Jaime-y-Yev/TFM/Presentación TFM - Jaime Salazar Lahera.pptx

## Intro

- Revolución Industrial (s. XVIII) → Automatización del campo (s. XXI)
- Agricultura de precisión
- Beneficios
  - Económicos: ↓ tiempo, trabajadores
  - Ecológicos: ↓ nutrientes, pesticidas, agua

Contexto

## Intro

- Vinbot → tamaño, visión
- Farmbot → sondeo, interfaz/control
- Nasa → pequeñas paladas
- Accesorios de tractores/camiones → dimensiones reales
- Bases para aficionados → Agent390 de Actobotics
  - Peso
  - Precio
  - Flexibildad

Inspiración

## Intro

- Base
  - Agujero central
  - Contorno de sonar
  - Oruga
- Delante
  - Batería de moto 12V 12Ah
  - Pared
  - ArduinoB y relé: batería secundaria 5V → convertidor boost → 12Vç
- Detrás
  - ArduinoA
  - Controlador de motores
  - Motores 12V c.c. con cepillo + codificadores

Anatomía

interruptor 3 posiciones → Motores, actuador lineal, servos

## Intro

- Centro
  - 2 RPi
    - PiA: navegación (GPS + motores)
    - PiB: sondeo, seguridad
  - Jaula sobre raíles
  - Servomotor + biela-manivela
  - Actuador lineal + sonda
  - Webcam
  - Baterías secundarias
  - Controlador de carga solar
  - Paneles solares, magnetómetro, antena GPS

Anatomía

## Intro

Parte A
- Infraestructura digital
  - Interfaz gráfica (webapp)
  - Base de datos SQL
  - Comunicación MQTT servidor-robot
- Navegación
  - Motores: dimensionado, control
  - Nav manual: MQTT a la cámara y los motores
  - Nav autónoma: comunicación serie PiA-ArduinoA
- Sondeo: almacenar y visualizar datos
- Visión: tomar fotos y analizar RGB
- Seguridad:
  - Batería principal: ↑ temp, humedad
  - Batería secundaria: ↓ tensión
- Dr. Alberto Brunete González + StackOverflow

Contribución

Parte B
Generación y envoi de mensajes
Resultados del sondeo
Estado(s) del robot
Cambio de modo
Navegación
GPS: configuración RTKlib
Algoritmos
Trayectoria PiA
Nav PiA
Nav ArduinoA + evitación de obstáculos: dimensionado, control

relé → batería

## Communicaciones

- Centralización y automatización
  - mantenimiento, errores
  - ↑ estandarización, rapidez de desarrollo, comodidad
- subprocess.Popen()
  - Mosquitto MQTT
  - SQLite3
  - Flask
    - Botón → publica MQTT → robot
    - Almacenar datos en SQL
    - Mostrar datos al usuario

Servidor

‘m’ o ‘r’

taskkill /T /PID

‘m’

‘r’

## Communicaciones

- MQTT
RobotServidor/modo/leer
servidor robot
RobotServidor/modo/escribir
- Talk about qos, retain?
- session
- dict json.loads() str

2

Página web

1

1

2

???

1

2 → 1

## Communicaciones

Página web

/rutas páginas.html
- render_template(index.html)
- render_template(crearParcela.html, {{ puntoCentro|tojson }}
puntoCentro=puntoCentro) JSON.parse() → xCentro, yCentro
- request.args.get() action=“get” ← botón
  - Sqlite3 (SELECT, INSERT, UPDATE) → Flask-SQLAlchemy (ORM)
  - Ej. idSesión → idParcela → geometría
  - empty or not
- request.json ajaxControlRobot() ← pubMQTT(topic, mensaje) ← botón
  - {“coordObj”: coordObj, “geometría”: geometría}
- jsonify(modo=modo, coordAct=coordAct, …) setInterval(getJSON())
- Nota: extender layout.html con Jinja p.14

GET

GET

GET

POST

GET

## Navegación

Motores

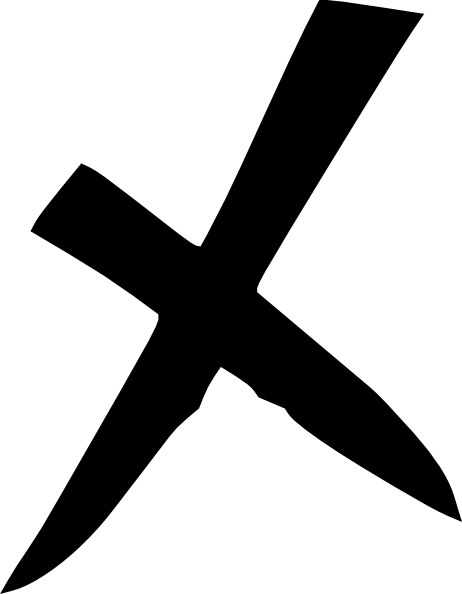
[picture p1: figure]

- Típicamente combustión interna
- Últimamente
  - John Deere: SESAM
  - Vinbot: base Robotnik SUMMIT-XL-HL usa motores c.c. sin cepillo
  - IG42 motores c.c. con cepillo
- Necesitamos compatibilidad y flexibilidad → Actobotics
  - Motores c.c. con cepillo
    - Mantenimiento, peor potencia/peso
  - Codificadores relativos de cuadratura y efecto Hall
    - Magnéticos vs. ópticos: mejor frente al polvo, vibraciones, temperatura

## Navegación

Motores

- Parte B: peso proyectado 29,82 kg (15 kg prototipo)
- Carga
  - 75-90% de RPMmax → n100, n90, …, n0 → curva → M100, M90, …, M0
  - M90 → F90 de cada motor
  - Ftotal de ambos motores
  - Masa a inclinación de 5° y 15°
  - 118 rpm puede con 65 kg

## Navegación

Motores

- Velocidad
  - n90 → v90
  - 118 rpm → 0,3 – 0,5 m/s
- Tracción
  - 118 rpm producen Mtotal90
M_i =F_(total_i) ∙r=F_(total_i) ∙(0,0485 m)⇒M_90 =F_(total90) ∙(0,0485 m)=(34,91 N)∙(0,0485 m)=1,69 Nm
  - Par limitado por la tracción

## Navegación

Controlador de Motores

RoboClaw 2x15A ArduinoA
- 20A parada motores → 30A pico → 10A límite cada motor
- 10 – 15V
  - Cables largos → inductancia → picos de tensión!
- Regenerativo → diodo!
  - 30V 25A pico
- erroresMotor()
  - Operador &

comandos
softwareSerial
codificadores

## Navegación

Controlador de Motores

- SpeedAccelM1(DIRECCION_MEMORIA_RC, ACELERACION, velocidad)
  - CRC16 → respuesta 0xFF
  - Controlador vigila QPPPS
  - En realidad envuelto
    - avanzarRecto() = SpeedAccelM1(vel, ACEL) + SpeedAccelM2(vel, ACEL)
    - avanzarIzq() = SpeedAccelM1(vel*PORCENT_VEL, ACEL) + SpeedAccelM2(vel, ACEL)
    - girarDcha() = SpeedAccelM1(vel, ACEL) + SpeedAccelM2(-vel, ACEL)
    - paradaSuave() = SpeedAccelM1(0, ACEL) + SpeedAccelM2(0, ACEL)
    - paradaFuerte() = SpeedAccelM1(0, 2*ACEL) + SpeedAccelM2(0, 2*ACEL)

## Navegación

Controlador de Motores

- Auto Tune
  - Menos y más agresivo
  - Oscilaciones → sobrecorriente daña motores → reducir D?
- Manualmente → suave!

## Navegación

Mapas

- Marcar coordObj en /controlRobot
- controlRobot.html
  - Mapa
  - Geometría de parcela
  - Trayectoria planeada
- OpenLayers
  - map = Map({
…,
view: View({
…,
projection: ESPG4326
}),
layers: [mapaBing, capaContorno, capaCoordObjs, …]
)}
  - capaContorno: figura Polygon(coordenadas de Flask)
  - capaCoordObjs: figuras Point()
  - capaTrayectoria()
  - coordAct: setInterval(setPosition(nuevaCoordAct), ms)
  - map.on(“click”, forEachFeaturaAtPixel(
getGeometry().getCoordinates()
)

según RTKLib

map.addLayer()
+
map.removeLayer()

## Navegación

Autónoma

- PiA: serial.serial(9600 bps, paridad=par, timeout=2)
- ArduinoA: Serial.begin(9600, 8E1)
PiA ArduinoA
1100001 → 11000011

## Navegación

Autónoma

PiA ArduinoA
comandoArduino(comando, valor) loop()
mensaje = comando + valor
write(mensaje.encode(‘utf-8’) mensaje[i] = Serial.read()
comando = mensaje[0]+mensaje[1]+’\0’
codigoComando = atoi(commando)
if codigoComando == CAMBIAR_MODO
*modoPuntero = mensaje[2] – ‘0’
respuesta = readline().decode{‘utf-8’) Serial.print(modo)
if comando == CAMBIAR_MODO
modo = int(respuesta)
if modo in modos
return modo

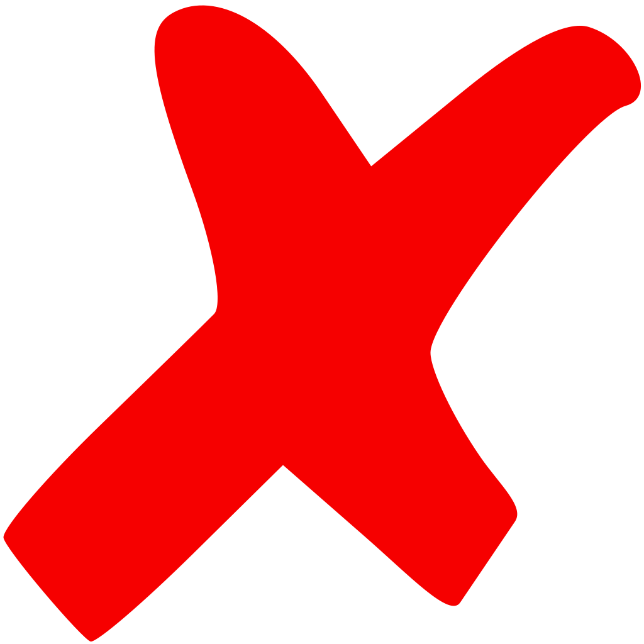
[picture p2: figure]

B

## Navegación

Autónoma

PiA ArduinoA
comandoArduino(comando, valor) importante!
While True fuente propia > 6,2 + 0,7V
try sensors conectados
except
if numExcepeciones > n
subirArduino()
subprocess.check_output(“arduino-cli upload –b uno ArduinoA.ino –p /dev/ttyACM0) vigilarArduino()

B

B

## Navegación

Autónoma

- También actualizarEncabezamientoArduino() + compilarArduino()
  - CAMBIAR_MODO = 11 → #define CAMIAR?MODO 11
- Principalmente al arrancar PiA
- Idealmente actualizaciones OTA desde el servidor

## Navegación

Autónoma:Sensores

- En Parte B PiA: coordAct (GPS), dirección y distancia objetivo
- Magnetómetro: comparar direcionAct con direccionObj → izq, dcha, recto?
  - Flora de Adafruit (LSM303DLHC)
  - I2C
- Ultrasonidos: evitar obstáculos
- navegaciónAutomática()

## Navegación

Autónoma: Magnetómetro

- Wire.beginTransmission(LSM303_ADDRESS_MAG)
  - START = flanco bajada SDA + nivel alto SCL
  - Adafruit_LSM303_U.h: #define LSM303_ADDRESS_MAG 0x3C >> 1 = 00111100 >> 1 = 00011110
  - Correcto según hoja de datos!
  - 0 1 1 1 1 0 0 → esclavos comparan
  - Bit de escritura = W = 0
- Maestro libera SDA → esclavo ACK (nivel bajo SDA durante puslo alto SCL)
  - Después de cada byte recibido
- Wire.write(LSM303_REGISTER_MAG_OUT_X_H_M)
  - OUT_X_H_M = 0x03 = 00000011 hoja de datos
- Wire.requestFrom(esclavo, 6)
  - En realidad dirección de 7 bits y 1 bit de autoincremento (0x03-0x08 por defecto en el chip)
  - Esclavo ACK, maestro SR + AD + R
- while (Wire.available() < 6)
  - 6 bytes de tipo uint8_t: x alto, x bajo, y alto, y bajo, z alto, z bajo
  - raw.x = (int16_t)(xlo | ((int16_t)xhi << 8)) show example
  - Complemento a dos: 11010010 01011011 → 00101101 10100100 → 00101101 10100101 = 11685 confirm
  - atan2() → declinación → 0 < 2π → direccionAct → calibrar a mano
- …STOP = flanco subida SDA + nivel alto SCL

## Navegación

Autónoma: Sonar

- HC-SR04: evitar obstáculos, lado mayor espacio entre filas, detener
- Trigger: pulso 10µs
- µM: recibe trigger → ráfaga (8 ciclos a 40 kHz)
- Transmisor: : tensión → efecto piezoeléctrico → 2 placas metálicas comprimen-expanden aire → onda sónica
- µM: mantiene pulso eco alto hasta recibir eco (interrupción)
- receptor: 3 op-amps para atenuar, filtrar, comparar con mínimo
- µM: pulseIn() → wiring_pulse.c → wiring_pulse.s calcula ciclos de reloj
- Calibrar: distancia = m*duración + b

## Navegación

Manual

- Teleoperación básica
- Página web publica commandos a motores y cámara

## Navegación

Manual: Movimiento

- controlRobot.html
  - <button
onmouseup= pubMQTT('ServidorRobot/navManual','ad')
onmousedown= pubMQTT('ServidorRobot/navManual',‘ps');"
>
  - ajax(control.topic, control.mensaje)
- Flask
  - clienteMQTT.publish(topic, mensjae)
- En Parte B PiA se subscribe, guarda el mensaje, y activa permitirComandoManual
- En Parte A PiA vigila el modo y la bandera → comandoArduino(COMANDO_MANUAL, mensaje)

## Navegación

Manual: Visión

- 2 servos SG90
- 12V batería principal → convertidor buck → 4,8-6V
- PWM por software con pigpio
- pubMQTT(n) → moverServoWeb(n)
  - n == 1 o n == 2 → pulsoActualAA++ o pulsoActualAA-- → arriba o abajo
  - n == 3 o n == 4 → pulsoActualID++ o pulsoActualID-- → izq o dcha
  - pulsoActual = get_servo_pulsewidth()
  - Teóricamente 500-2500 µs pero límites averiguados manualmente
  - moverServo() sólo permite set_servo_pulsewidth() entre los respectivos límites

## Navegación

Manual: PWM

- RPi 3B+ varias patillas PWM pero sólo 2 canales y servo jaula en parte B!
- Además, librería GPIO + condensador era inestable (movimiento entrecortado, vibraciones)
- Establece mapa de memoria GPIO via DMA directamente en controlador PWM sin utilizer la CPU
  - 41 registros GPIO
  - Registro GPSET0 escribe nivel a la patilla, GPLEV0 lee su nivel actual
- DMA en BCM2835
  - Bloques de control: 8 palabras de 32 bits
  - Lista enlazada de bloques → secuencia de instrucciones

## Navegación

Manual: PWM

- set_servo_pulsewidth() en Python → gpioServo()
- gpioInfo[patilla]: modod de la patilla, anchura de pulso actual, rango de pulsos
- myGpioSetMode
  - reg = gpio/10 = 19/10 = 1,9 → registro 1
  - shift = (gpio%10)*3 = (19%10)*3 = 9*3 = 27
  - & y |
- myGpioSetServo
  - Páginas (4096 bytes) y slots
  - ON primer slot → OFF slot estratégicamente elegido a cierta ‘distancia’ según pulso
  - FIFO del PWM acepta nuevas instrucciones según las va ejecutando → retardo específico

## Navegación

Manual: Video

- Demasiado grande y cosntante para MQTT
- mjpg-streame: con IP y Puerto de PiB se ve a tiempo real
- Modo manual?
  - mostrarVideo() → start.sh
- Detectar cambio de modo
  - Autónomo: tomar fotos en hilo Sondeo
  - Manual: mostrar video en hilo Video
  - Grupo de procesos = os.getpgid() → os.killpg(SIGTERM), SIGKILL no libera del todo?

## Resultados

Fotos

- tomarFotos()
  - girarCentroIzq(): moverServo()
  - tomarFoto(‘I’)
    - pygame.get_image() → RGB 24 bits
    - save() → nombreFoto = tiempo + lado + .bmp
  - subprocess.check_output(./fotos nombreFoto)
    - fotos.c
      - Lee encabezamientos
      - Bucles recorren filas y pixels cargando grupos de 3 bytes (RGB)
        - VARI = (G-R)/(G+R+B)
- En realidad NIR > RGB
- Si VARI > límite → buen pixel → … → porcentaje pixels Buenos
- Mejor calibración: para cada cultivo, etapa de crecimiento
- Continuar para lado ‘D’
- resultadosSondeo.update(resultadosFotos) → publicar a RS/resultados/medidas y RS/resultados/fotos

## Resultados

Web

- Sub MQTT
  - json.loads()
  - resultados[‘coordObj’], resultados[‘temp’], resultados[‘hum’], etc.
  - INSERT
- /verParcela
  - SELECT
  - verParcela.html
- Mayor o menor intensidad de puntos
  - 3 capas
  - Distribuir puntos según valor
- Casilla alterna entre tipo de resultado

## Seguridad

Alimentación

- Interruptor 3 posiciones → pared o batería
- Relé
- Puente H, controlador motores, convertidor buck (2-3A)
- Sólo 1 servo a la vez
  - Jaula o cámara, un servo u otro de la cámara
- 2 paneles solares 12V → controlador de carga MPPT → batería principal
  - 12V en paralelo pero mejor 24V en serie para menor corriente → menor pérdidas
  - MPPT: emparejar Vpaneles con Vbatería ej. 17,6V y 7,4A → 12V y 10,8A
    - Convertidor c.c. a c.c.: entrada c.c. → señal c.a. altra frecuencia → rectifica a 12V c.c.
  - Mejor para batería secundaria

## Seguridad

Detección de Emergencias

- Control IR
- Temperatura y humedad batería principal
- Nivel batería secundaria

## Seguridad

Detección de Emergencias: Control Remoto

- Página web
  - pubMqtt(modo)
  - PiB guarda en global
  - otro hilo reconoce cambio de modo
  - si emeregencia → batería.desconectar → pulso pinterrumpe a ArduinoB
- Control IR
  - No quieres recibir cualquier IR → transmisor a cierta frecuencia
  - Irremote.h: interrupciones de T2 cada 50 µs para recibir
    - enableIRin() → en IrRecv,cpp cli()
    - Boarddefs.h: modificar TCCR2A y TCCR2B
      - TCCR2A = 0000XX10 y TCCR2B = 00XX0010
      - WGM22:0 = 010 → modo CTC, TOP=OCR2A
      - CTC: resetear temprizador cuando TCNT2 = OCR2A
      - CS22:0 = 0101 → prescalado = 8 → 16MHz/8 = 2MHz
      - OCR2A = (16 Mhz*50 µs / 10^-6 s/µs) / 8 = 100 ciclos
      - Marca OCF2A → interrumpir en próximo ciclo del reloj
      - Resetear OCF2A y TCNT2
      - COM2A1:0 y COM2B1:0 = 0000: no activar patilla OC2A
      - Con esta patilla se podría PWM: WGM21:0 modo, OCR2A modula ciclo de trabajo, salida OC2A → se;al PWM a base de interrupciones
- Receptor mierda
  - Varios mensajes distintos del mismo bot’on
  - Librerías y mandos distintos
  - Protocolos: NEC; SONY, RC5, RC6 → pero aún así distintos valores (ni siquiera grupo de valores)

## Seguridad

Detección de Emergencias: Temperatura y Humedad

- DHT11
  - temp NTC
  - hum resistivo
- 1 línea bidireccional, grupos de 8 bits
- Libre en alto
- ArduinoB baja durante 18 ms y sube → espera 20-40 µs respuesta del sensor (baja 80 µs)
- Sensor sube otros 80 µs para inidicar que va a enviar datos
- A cada bit de datos le precede baja 50 µs
- Pulso alto 26-28 µs = 0, 70 µs = 1
- Tras último bit señal baja 50 s y línea vuelve a subir (libre)
- 40 bit datos: hum entera, hum decimal, temp entera, temp decimal, suma

## Seguridad

Detección de Emergencias: Temperatura y Humedad

- read11()
  - noInterrupts() para no perturbar ritmo del código: 0 en bit 7 de SREG
  - Bucle de 40 contando hacia atrás
  - Lee estado de la línea con acceso directo al puerto
  - Patilla A0 Puerto C, 3 registros
    - DDRC: entrada o salida
    - PORTC: escribe a la patilla
    - PINC: lee de la patilla
    - Cada bit de estos registros representa patilla XXXXXXXY para A0
    - digitalPinToBitMask(14) → pgm_read_byte(14) → digital_pin_to_bit_mask_PGM[14] = _BV(0) 00000001 < 0 = 00000001
      - PROGMEM (Flash) porque no cambian, m’as lento pero major no ocupar SRAM limitada
    - Digital_pin_to_port[14] = PC y portInputRegister(PC)
  - digital?_pint_to_pot_PGM[14] = PC y *PIR = portToInputRegister(PC)
  - Bajar línea durante DHTLIB_DHT11_WAKEUP = 18 ms
  - Espera a respuesta con *PIR & bit
  - Pero tiempo límite para responder de 100 µs = 400 bucles show equation
    - Detecta flanco de bajada (actual bajo, previo no)
    - Avanza con una máscara inicial 128 grabando en data 0 o 1 dependiendo de duración
    - Guarda datos en bits[], pasa a siguiente byte, reinicia máscara 128
    - Datos en bits[0:3] y suma = bits[4]
- Suavizar temp y hum porque alguna vez un pico
  - Un poco arriesgado pero suficientemente rápido para mostrarse en la media
- Temp o hum excesiva lleva a modo emergencia, PiB lee esta variable eventualmente pero mejor una interrupción

## Seguridad

Detección de Emergencias: Nivel

- Si batería secundaria baja demasiado, desconectar bater’ia principal
- Realmente no necesario porque relé se apagaría automáticamente
- Pero evitar comportamiento errático
- Comparar referencia interna 1,1, V con tension de Fuente
  - En ADC elegir referencia mayor y entrada analógica con ADMUX ¡ 01001110
  - REFS1:0 = 01 → referencia = Fuente
  - MUX[3:0] = 1110 → entrada del ADC = 1,1 V
  - En ADCSRA ADSC=1 → empieza conversion (baja al acabar) → bucle mientras bit_is_set()
  - ADC guarda en ADCL y ADCH por ello (ADCH<<8) | ADCL ej 695
  - Teniendo en cuenta VIN = entrada de ADC = 1.1 V y VREF = referencia del ADC = Fuente → VREF = 1620,7 mV show equation
  - En realidad 1023 no?

## Seguridad

Conexión/Desconexión

- attachInterrupt()
  - digitalPintToInterrupt: patillas 2 y 3 → interrupciones 0 y 1
    - Máx prioridad
  - conectarBateria()/desconectarBateria()
  - RISING
- Número de la interrupción y modo → EICRA y EISM
  - EJ. Interrupción 1 y modo RISING=3 → ISC11:0 show work
