Jaime-y-Yev/TFM/Robot/actualizarCodigosDeComandos.py

# Copia los códigos de los comandos de RPi para Arduino (comandosParaArduino.py) al encabezamiento del Arduino (comandos.h)
# No es una función crítica del proyecto, es simplemente una herramienta de utilidad para asegurar que RPi y Arduino están de acuerdo

def actualizarEncabezamientoArduino(archivoPi, archivoArduino):
	"""Copiar las constantes de comandosParaArduino.py a comandos.h"""
	
	print("Actualizando encabezamiento del Arduino")

	# Leer de comandosParaArduino.py
	comandosPi = open(archivoPi,'r')

	# Escribir en comandos.h
	comandosArduino = open(archivoArduino,'w')

	# No empezar a copiar líneas de un archivo a otro hasta indicarlo
	copiar = False

	# Copiar las líneas de comandosParaArduino.py sólo en la sección delineada
	for línea in comandosPi:
			   
		# Dejar de copiar al llegar al final de la sección permitida
		if línea == '### FINAL DE CÓDIGOS --- NO MODIFICAR ESTA LÍNEA ###\n':
			break

		# Copiar mientras siga permitido, ignorando las líneas en blanco
		if copiar == True and línea != '\n':

			# Ej: del el archivo .py de RPi al archivo .h de Arduino
			#            "LEER_MODO = 10" --> "#define LEER_MODO 10"
			comandosArduino.write('#define ')
			línea = línea.replace(" = "," ")
			comandosArduino.write(línea)
		
		# Empezar a copiar al llegar al principio de la sección permitida 
		if línea == '### COMIENZO DE CÓDIGOS --- NO MODIFICAR ESTA LÍNEA ###\n':
			copiar = True
		
	# Cerrar los dos archivos
	comandosPi.close()
	comandosArduino.close()


# Esta función actualiza el archivo comandos.h de Arduino pero no lo compila ni sube al Arduino
archivoPi = '/home/pi/TFM/Robot/comandosParaArduino.py'
archivoArduinoA = '/home/pi/TFM/Robot/ArduinoA/headers/comandos.h'
archivoArduinoB = '/home/pi/TFM/Robot/ArduinoB/headers/comandos.h'

#actualizarEncabezamientoArduino(archivoPi,archivoArduinoA)
#actualizarEncabezamientoArduino(archivoPi,archivoArduinoB)


import subprocess
from time import sleep


def compilarArduino():
	"""Compilar el Arduino"""
	
	# Seguir intentando hasta compilar el Arduino exitosamente 
	resultadoCompilacion = ""
	while resultadoCompilacion != "bytes":
		print("\nCompilando Arduino")
		
		resultadoCompilacion = subprocess.check_output(['arduino-cli', 'compile', '-b', 'arduino:avr:uno', '/home/pi/TFM/Robot/ArduinoA'], shell = False)
		#print("resultadoCompilacion = ", resultadoCompilacion)
		#print()
		resultadoCompilacion = resultadoCompilacion[-7:-2]
		resultadoCompilacion = resultadoCompilacion.decode()
		#print("resultadoCompilacion = ", resultadoCompilacion)

		if resultadoCompilacion == "bytes":
			print("Arduino compilado con éxito")
		else:
			print("Problema al intentar compilar, reintentando...")

	sleep(2)
	

def subirArduino():
	"""Subir el Arduino"""
	
	# Seguir intentando hasta subir el Arduino exitosamente 
	resultadoSubida = "blahblah"
	while resultadoSubida != "":
		
		print("\nSubiendo el Arduino")
		resultadoSubida = subprocess.check_output(['arduino-cli', 'upload', '-b', 'arduino:avr:uno', '/home/pi/TFM/Robot/ArduinoA', '-p', '/dev/ttyACM0'], shell = False)
		#print("resultadoSubida = ", resultadoSubida)
		#print()
		resultadoSubida = resultadoSubida.decode()
		#print("resultadoSubida = ", resultadoSubida)

		if resultadoSubida == "":
			print("Arduino subido con éxito")
		else:
			print("Problema al intentar subir, reintentando...")
	
	sleep(2)	

#compilarArduino()
#subirArduino()
