Jaime-y-Yev/TFM/(commit log)

2018-10-08 funciones mqtt trasladadas de servidor.py a Flask
2018-10-11 Limpieza de los templates
2018-10-11 Añadí ArduinoB.ino
2018-10-19 Limpieza de actualizar.py y comandos.py
2018-10-20 Depuración de actualizar.py y comandos.py
2018-10-23 Añadir PiA y ArduinoA
2018-11-03 Antes de reorganizar ArduinoA
2018-12-09 Antes de cambios antes de navidad
2018-12-09 Antes de cambios de navidad
2018-12-09 Cambios antes de navidad
2018-12-09 Borrado ArduinoA
2018-12-09 Añadido ArduinoA
2019-01-04 Mezcla de mqttPiA y PiB
